michaelbudisch/Keller-Sensorzentrale/enclosure/README.md

# 3D-Gehäuse / MakerWorld

**[→ Gehäuse und Druckprofil auf MakerWorld ansehen](https://makerworld.com/en/models/3464324-wemos-d1-gehause-fur-ds18b20-und-relais#profileId-3953596)**

Für die Keller Sensorzentrale existiert bereits ein vom Projektinhaber entworfenes Gehäuse. **Die 3MF-/STL-Dateien wurden noch nicht zur Repository-Erstellung bereitgestellt.** Fotos und CAD-Ansichten des fertigen Prototyps sind jetzt in der [Projektgalerie](../docs/galerie/README.md) vorhanden. Wir fügen hier bewusst keine erfundenen Modelle, Maße oder Druckprofile hinzu.

## Hier später ablegen

```text
enclosure/
├── README.md
├── MAKERWORLD-TEXT.md
├── models/       ← 3MF, STL, STEP (wenn vorhanden)
├── photos/       ← Gehäusefotos / Explosionsansicht
└── profiles/     ← Slicer-Profil, optional
```

Zur fertigen Dokumentation werden benötigt: finaler 3MF/STL-Stand, Innenmaße / Platinenaufnahme, Verschraubung, Kabelführungen, USB-Zugang, Material- und Druckeinstellungen, Fotos und gewünschte Nutzungs-/Remix-Lizenz.

## Verknüpfung

**[MakerWorld: Wemos D1 Gehäuse für DS18B20 und Relais](https://makerworld.com/en/models/3464324-wemos-d1-gehause-fur-ds18b20-und-relais#profileId-3953596)**

Die 3D-Druck-Dateien werden über die MakerWorld-Modellseite angeboten. Die zugehörige Firmware und die Home-Assistant-Integration befinden sich in diesem GitHub-Repository. Die jeweiligen Lizenzbedingungen sind separat zu prüfen.

Das Gehäuse allein stellt keine elektrische Sicherheit, Flammschutz-Zulassung oder Eignung für Heizöltanks bzw. Ex-Zonen sicher.

## Fertige Beschreibungstexte

[MakerWorld-Beschreibung auf Deutsch und Englisch](MAKERWORLD-TEXT.md). Das Modell ist inzwischen auf MakerWorld veröffentlicht. **Die Bilder sind keine Maßzeichnungen.**
