michaelbudisch/Keller-Sensorzentrale/docs/galerie/README.md

# Projektgalerie – Keller Sensorzentrale

Fotos des aufgebauten Prototyps und Screenshots der beiden Oberflächen. Die Bilder zeigen **eine individuelle Lochrasterplatine**: Maße und Steckerlagen können bei Nachbauten abweichen.

## Gehäuse und Elektronik

Offenes Gehäuse mit Wemos D1 mini, Sensorplatine und Relais
*Innenaufbau des Prototyps mit abgenommener Abdeckung.*

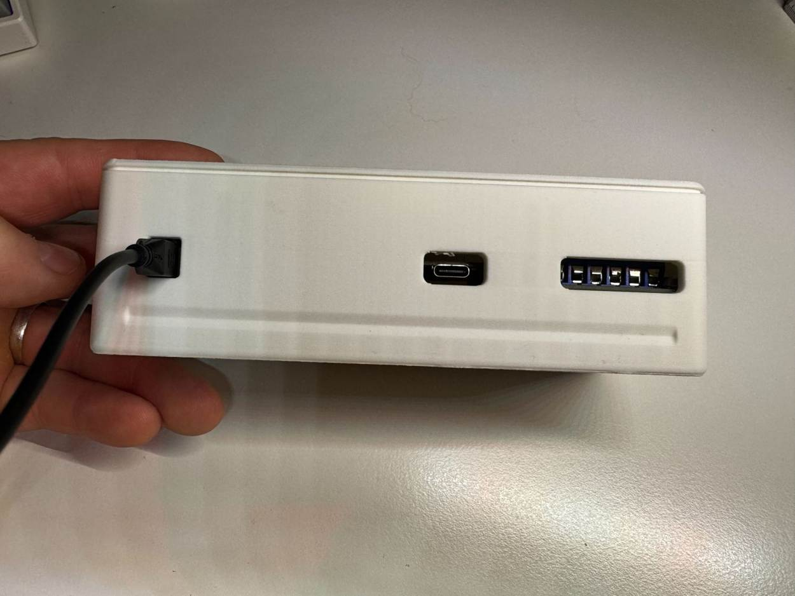
[picture p4: docs/galerie/02-anschluesse.jpg]
Gehäuseanschlüsse an der Längsseite

*Zugängliche Anschlussseite des 3D-gedruckten Gehäuses.*

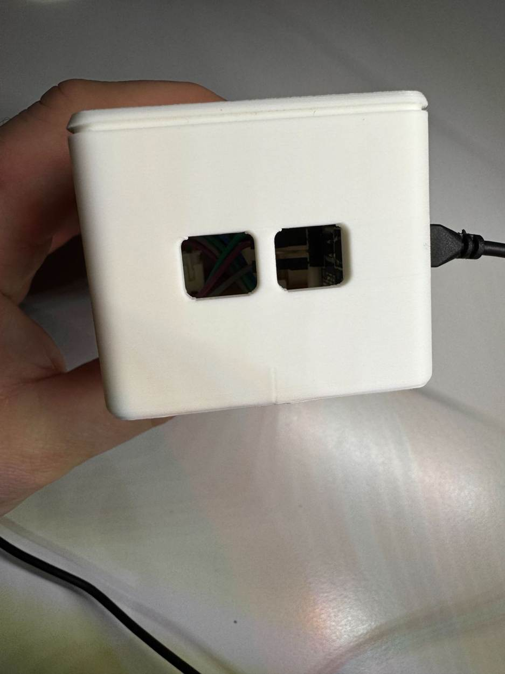
[picture p5: docs/galerie/03-gehaeuse-seite.jpg]
Gehäuse-Seite

*Seitliche Kabelöffnungen.*

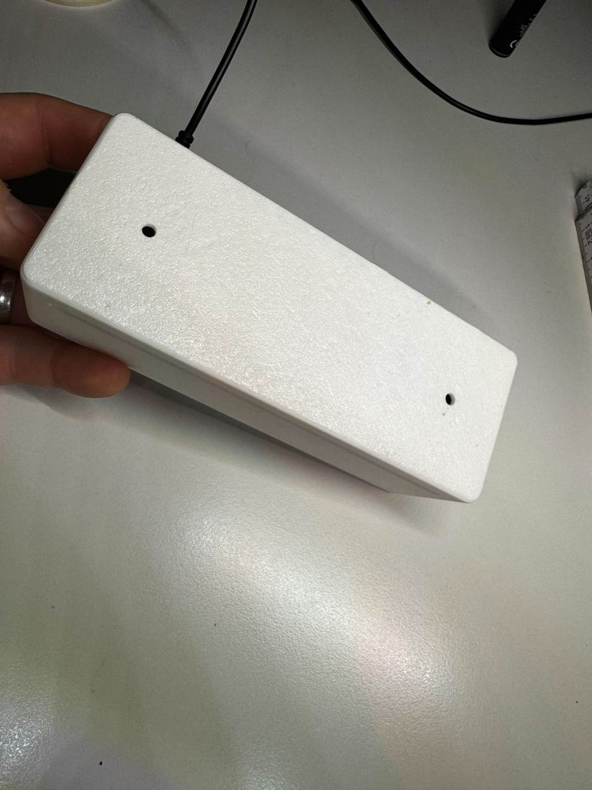
[picture p6: docs/galerie/04-deckel.jpg]
Deckel

*Geschlossener Deckel mit Befestigungspunkten.*

## Montage und CAD

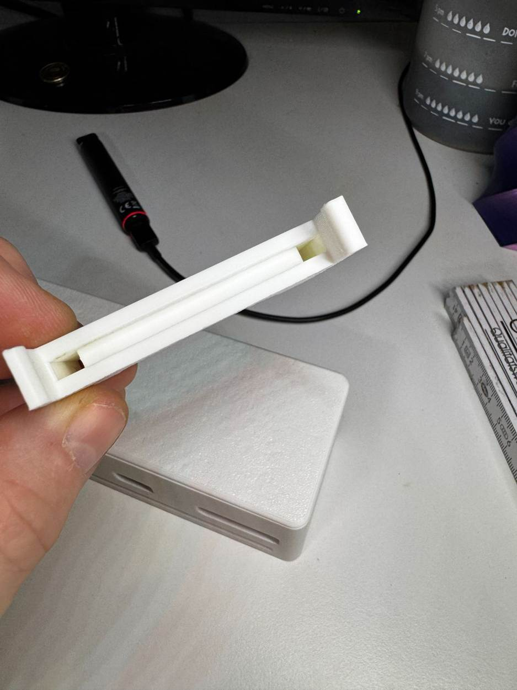
[picture p7: docs/galerie/05-rohrhalter.jpg]
Gedruckte Rohrhalterung

*Einfacher gedruckter Halter des Prototyps.*

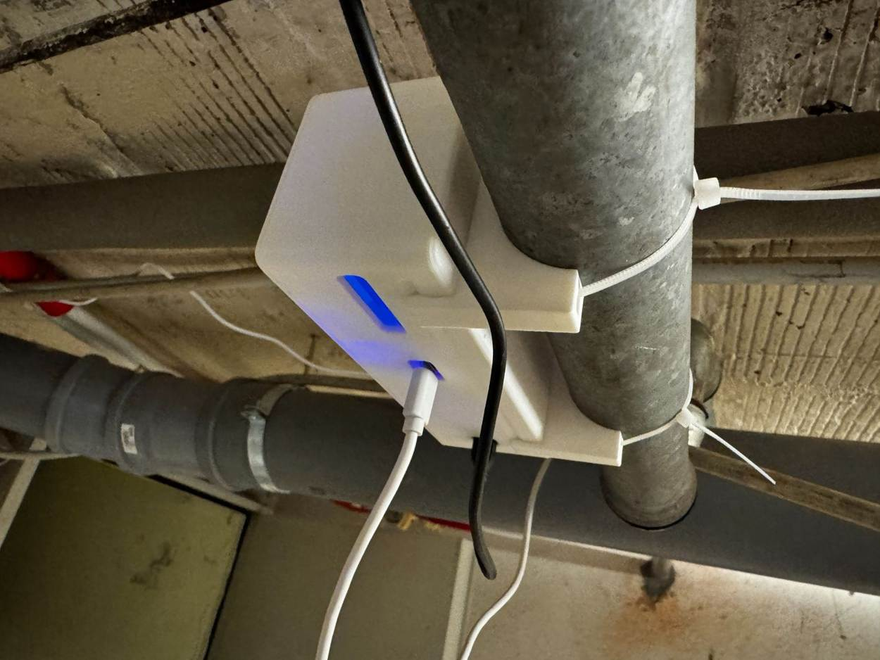
[picture p8: docs/galerie/06-rohrmontage.jpg]
Gehäuse am Rohr montiert

*Individuelle Rohrmontage, hier mit Kabelbindern.*

Montiertes Gerät mit Statusbeleuchtung
*Fertig montierter Aufbau im Keller.*

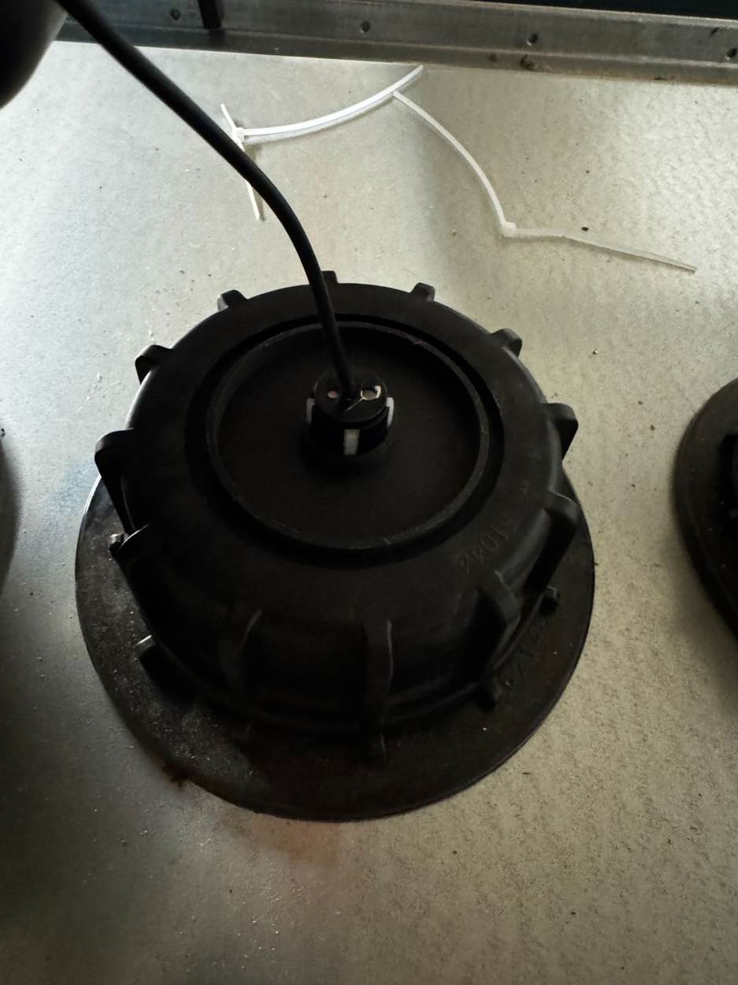
[picture p9: docs/galerie/08-tanksensor.jpg]
Tanksensor am Deckel des Prototyptanks

*Der vorhandene Tankaufbau: **kein** universeller Montageplan und keine Aussage über Tankabdichtung oder Zulassung.*

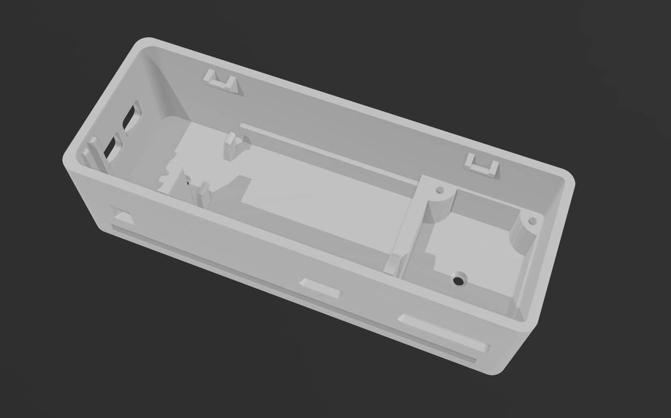
[picture p10: docs/galerie/09-cad-innenansicht.jpg]
CAD-Innenansicht

*CAD-Ansicht mit Haltestrukturen. [3D-Druck-Modell auf MakerWorld](https://makerworld.com/en/models/3464324-wemos-d1-gehause-fur-ds18b20-und-relais#profileId-3953596).*

## Software

Home Assistant Kellersteuerung
*Home Assistant: Relais, Sensor-Slots, Tankfüllstand und Langzeitverläufe.*

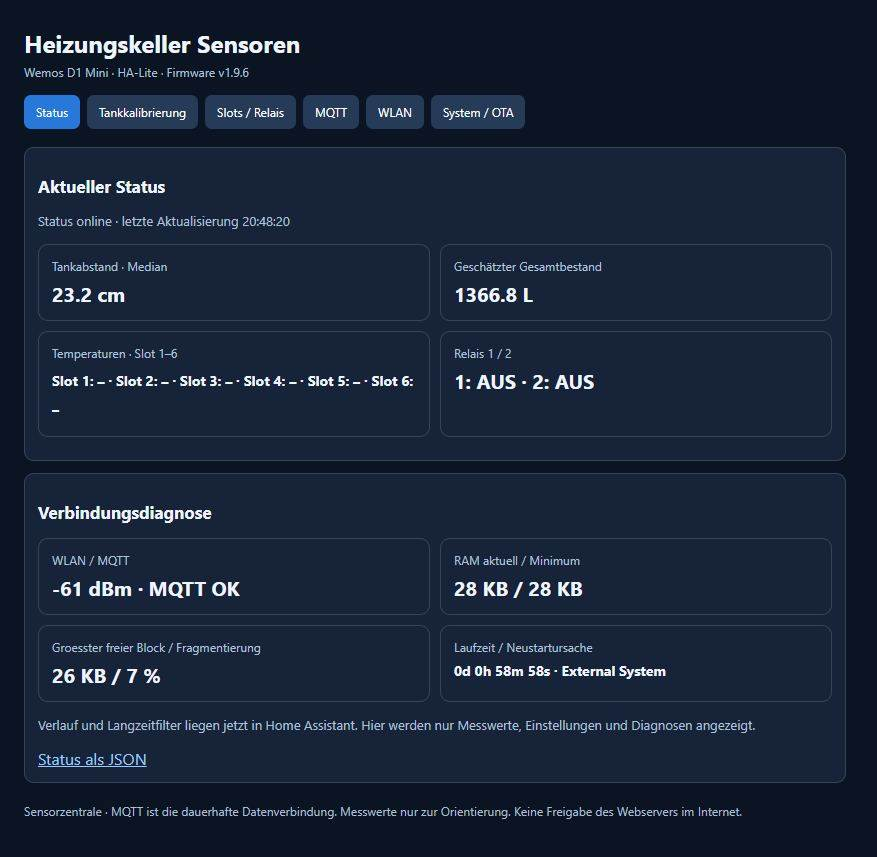
[picture p11: docs/galerie/11-wemos-status.jpg]
Wemos-Status

*Lokale kompakte Status- und Konfigurationsoberfläche des Wemos.*

## Nutzungsrechte und Privatsphäre

Die öffentlich bereitgestellten Fotos sind zur Veranschaulichung des Projekts gedacht. Die MIT-Lizenz des Quellcodes ist **keine pauschale Fotolizenz**. Bitte frage vor einer Weiterverwendung oder dem Nachdruck der Bilder nach. Beim Export wurden Bildmetadaten entfernt.

Das gezeigte Gehäuse ist ein 3D-Druck-Prototyp und nicht als zertifizierte Schutzeinrichtung oder für netzspannungsführende beziehungsweise explosionsgefährdete Installationen geprüft.
