michaelbudisch/Keller-Sensorzentrale/PROJECT_STATUS.md

# Projektstatus – Keller Sensorzentrale

**Stand:** 20.10.2026 · **GitHub-Dokumentationsstand:** v0.2.2 · **Status:** im eigenen Aufbau erprobter Prototyp, kein zertifiziertes Fertigprodukt.

> **Startpunkt für neue Chats und Beiträge:** Vor Änderungen diese Datei und die jeweils aktuellen GitHub-Quelldateien lesen. Der Code im Branch `main` ist die öffentliche Quellbasis; die genaue Konfiguration des bereits installierten Geräts kann davon abweichen. Für Live-Einstellungen und Probleme stets aktuelle Screenshots, Diagnosedaten oder Konfigurationsauszüge heranziehen. Keine Passwörter oder privaten Zugangsdaten ins Repository übernehmen.

## Neuestes Frontend: natives Lovelace-Dashboard

Seit dem 22.10.2026 steht **`home-assistant/Kellersteuerung_Lovelace.yaml`** als neue Standardoberfläche zur Verfügung. Sie wurde statisch validiert, ist aber **noch nicht live im HA des Nutzers getestet**. Sie ersetzt bei erfolgreichem Einsatz das bisherige **eigene** Seitenpanel im Alltag, ohne dessen Installation oder Dateien zu löschen. Einbindung und fehlende Entitätsnamen stehen in [LOVELACE_DASHBOARD.md](docs/home-assistant/LOVELACE_DASHBOARD.md).

## 1. Projektüberblick

Ein Wemos D1 mini (ESP8266) liest einen Ultraschall-Tanksensor und bis zu sechs DS18B20-Temperatursensoren aus, steuert zwei Relais und veröffentlicht die Werte über MQTT an Home Assistant. Im Wemos bleiben Messung, kurzer Median, 16-Punkte-Tankkennlinie, Sensorzuordnung, Relais, Einstellungen und Diagnose. Home Assistant übernimmt zeitliche Glättung, Verlauf, Anzeige und die optional aktivierbare Heizöl-Verbrauchs-/Nachtank-Auswertung.

| Bereich | Öffentlicher Stand | Praxiserfahrung / Grenzen |
| --- | --- | --- |
| ESP8266-Firmware | **v1.9.6 (HA-Lite / Statusfix)** | Eingebauter Wemos übermittelt Tankwerte und MQTT-Status; GitHub-Sketch ist eine von Zugangsdaten bereinigte Vorlage, kein binär identisches Abbild des laufenden Geräts. |
| Home Assistant | **HA-Pakete v2.1.0, Seitenpanel v2.4.0, Lovelace-Karte v2.1.1** | Tankabstand, geglättete Liter und Gesamtbestand erschienen in HA; Schalten der Relais über MQTT/HA wurde beobachtet. |
| Tankmessung | **Aktiv, ein Sensor** | Bei der letzten Rückmeldung funktionierten Distanzmessung und Literanzeige. Beide mechanischen Tankuhren zeigten ungefähr den gleichen Stand; exakte Messtoleranz nicht bestimmt. |
| Tankhochrechnung | **Zwei gleichartige Tanks** | Gemessen wird ein Tank; der zweite wird aus gleichem angenommenem Füllstand hochgerechnet. Im HA-Package ist die aktuelle Einzelkapazität **720 L** für den Prozentwert fest hinterlegt; bei anderen Tanks anpassen. |
| Temperaturslots | **Sechs Buchsen/Slots vorgesehen** | **Zwei angeschlossene DS18B20 an D1 erkannt.** Slot 1 ist als Heizungsvorlauf und Slot 2 als Rücklauf montiert; Screenshot: 37,3 °C und 33,6 °C (3,7 K Spreizung). D2/D5 und Recorder-Verlauf noch nicht getestet. |
| Relais | **Zwei Kanäle** | Status/Steuerung aus HA möglich, lokale Belastbarkeit, Versorgung und dauerhafter Betrieb noch nicht abschließend qualifiziert. Keine Netzspannung/Sicherheitsfunktionen. |
| Verbrauchsstatistik | **Optionales HA-Package vorhanden** | Helfer `input_boolean.keller_verbrauch_aktiv` existiert. Die tatsächliche spätere Aktivierung und belastbare Tages-/Wochen-/Monats-/Jahreswerte sind **nicht abschließend bestätigt**. |
| 3D-Gehäuse | **Veröffentlicht** | [MakerWorld-Modell + Druckprofil](https://makerworld.com/en/models/3464324-wemos-d1-gehause-fur-ds18b20-und-relais#profileId-3953596), [Fotos und Montage](docs/galerie/README.md). Die 3MF/STL-Dateien liegen auf MakerWorld, nicht im GitHub-Repository. |

**Zuletzt gezeigte Beispielwerte (19.10.2026, keine Live-Werte):** Wemos ca. **23,2 cm** Tankabstand und **1.366,8 L** hochgerechneter Bestand. Home Assistant wegen 5-Minuten-Glättung zeitlich versetzt ca. **1.353,8 L / 94,0 %**; früher auch ca. 1.358,8 L / 94,4 %. Solche Momentaufnahmen dürfen nicht als statische Konfigurationswerte oder gesicherte Füllmengen übernommen werden.

## 2. Hardware und GPIO-Belegung

| Anschluss | Wemos D1 mini | Verwendung |
| --- | --- | --- |
| Slot 1 + 2 | **D1 / GPIO5** | 1-Wire-Datenbus A, ein Pull-up (ca. 5 kΩ) an 3,3 V |
| Slot 3 + 4 | **D2 / GPIO4** | 1-Wire-Datenbus B, ein Pull-up (ca. 5 kΩ) an 3,3 V |
| Slot 5 + 6 | **D5 / GPIO14** | 1-Wire-Datenbus C, ein Pull-up (ca. 5 kΩ) an 3,3 V |
| Tank ECHO/TX | **D6 / GPIO12** | Abstandspulse, **mit** geeigneter 5-V-auf-3,3-V-Pegelanpassung |
| Relais 1 | **D7 / GPIO13** | Schaltausgang, im Sketch active LOW voreingestellt |
| Relais 2 | **D0 / GPIO16** | Schaltausgang, im Sketch active LOW voreingestellt |

- **Sechs 3-Pin-Stecker:** jeweils **3V3, DATA, GND**; zwei pro 1-Wire-Bus. Physische Pinreihenfolge keinesfalls aus Fotos ableiten.
- **Zwei 4-Pin-Stecker:** Tank (5V/GND/TX-ECHO/RX-TRIG; RX derzeit frei) und Relais (5V/GND/IN1/IN2). Beide Anschlüsse elektrisch unterscheiden und prüfen.
- **Achtung Pegel:** Der verwendete Prototyp wurde mit drei 5-kΩ-Widerständen als Spannungsteiler aufgebaut (5 kΩ oben / 10 kΩ unten); das liefert nominell **3,33 V** und wenig Reserve. Die [öffentliche Nachbauanleitung](docs/hardware/ANSCHLUSSPLAN.md) beschreibt eine konservativere Pegelanpassung. Kein 5-V-Signal direkt an den GPIO!
- Hardwareanleitungen: [Bauanleitung](docs/hardware/BAUANLEITUNG.md) · [Netzliste](docs/hardware/ANSCHLUSSPLAN.md) · [SVG-Prinzipbild](docs/hardware/anschlussplan.svg) · [Stückliste](docs/hardware/STUECKLISTE.md).

## 3. Software, Datenfluss und Kompatibilität

**Wemos:**
- [`firmware/KellerSensorzentrale/KellerSensorzentrale.ino`](firmware/KellerSensorzentrale/KellerSensorzentrale.ino) – öffentliches v1.9.6-Quelltemplate, drei `#BITTE_AENDERN`-Platzhalter, ESP8266-Boardpaket, WiFiManager, PubSubClient, OneWire und DallasTemperature.
- EEPROM speichert Kalibrierung/Zuordnungen und Geräteeinstellungen. Vor Änderungen oder OTA die lokale Konfiguration sichern.
- Die abgespeckte Weboberfläche dient der Konfiguration und Diagnose; MQTT ist der primäre Home-Assistant-Datenweg.

**Home Assistant:**
- [Installationsanleitung](docs/home-assistant/INSTALLATION.md) und [Dateien](home-assistant/).
- Bestehende Namen aus Kompatibilitätsgründen beibehalten: `www/heizoel-monitor-card.js`, `custom_components/heizoel_dashboard_panel`, Panel-Pfad `/heizoel-monitor`; sichtbarer Titel **Kellersteuerung**.
- Seitenpanel-Update v2.3.1: Heizkreis mit Taktanalyse im eigenen Reiter, Ölbereiche getrennt, ein optionales Package (v1.0.1) liefert abgeleitete Aktivphasen und Statistiken. Im realen HA installiert; erste Tests funktionieren, die Aussagekraft muss über mehrere Tage geprüft werden. [Ausführliche Anleitung](docs/home-assistant/HEIZTAKTE.md).
- Seitenpanel-Update v2.2.0: Vorlauf und Rücklauf standardmäßig aus Slot 1/2, optionaler Spreizungs-Helfer und getrennte Achsen im Verlauf; [Installationsanleitung](docs/home-assistant/INSTALLATION.md#heizkreis-anzeige-im-seitenpanel-v220).
- Lovelace-Kartenupdate v2.1.1: Eine alte `entity:`-Angabe in Karten-YAML darf `entities.total` nicht überschreiben. Bei alter Karte JS-Datei ersetzen, Ressource `/local/heizoel-monitor-card.js?v=211` nutzen und YAML prüfen; siehe [Installation](docs/home-assistant/INSTALLATION.md#lovelace-karte-alte-anzeige-oder-falscher-gesamtbestand).
- HA-Packages liegen im Ordner **`packages/` unmittelbar neben der aktiven `configuration.yaml`**. Bei der realen Installation führte ein irrtümliches zusätzliches `config/`-Unterverzeichnis dazu, dass Helfer zunächst fehlten.
- Bestätigte MQTT-Rohentität: **`sensor.heizungskeller_sensoren_abstand_geglattet`**, ausdrücklich **`geglattet`**, nicht `geglaettet`. Dies war zuvor ein echter Zuordnungsfehler.
- HA-Filter/Template-Entitäten: `sensor.keller_tank_abstand_5min`, `sensor.keller_tank_einzeln_5min`, `sensor.keller_tank_gesamt_5min`, `sensor.keller_tank_fuellstand_5min`.
- Verbraucher-Helfer: `input_boolean.keller_verbrauch_aktiv`. Der Verbrauchsalgorithmus enthält Schwellenwerte und benötigt die Prüfung anhand realer Tage, längerer Ausfälle und Nachtank-Vorgänge. Nicht eigenmächtig Null setzen oder Statistiken zurücksetzen.

## 4. Bekannte Grenzen und noch offene Prüfungen

1. **Webserver-Stabilität:** Historisch war die Weboberfläche zeitweise unerreichbar, während MQTT/HA-Relais weiter funktionierten. Nach HA-Lite ca. **27–29 KB freier Heap** in gezeigten Momentaufnahmen, aber **keine belastbare Langzeit-Entwarnung**. Bei neuen Ausfällen Heap-Minimum, größter Block, Fragmentierung, Neustartursache, Laufzeit sowie WLAN/MQTT erfassen.
2. **Langzeittest und Zuverlässigkeit:** Keine systematisch dokumentierten Wiederanlauf-, Sensorabbruch-, WiFi/MQTT-Ausfall- und Relaisschalt-Lasttests.
3. **Temperatur:** D1 mit zwei erkannten DS18B20 bestätigt. D2/D5 und Recorder-Verlauf sowie neue Heizkreis-Grafik im laufenden HA testen. Für 30-Tage-Grafiken Recorder-Aufbewahrung prüfen.
4. **Tankkalibrierung:** Gegen die mechanischen Uhren plausibilisiert, aber Verbrauchsschwellwerte, Toleranzen und Tankgleichlauf über Zeit sowie Füllstand bei verschiedenen Pegeln noch zu prüfen.
5. **Firmware-Build:** Die öffentliche v1.9.6-Vorlage wurde beim Projekt-Export **nicht als vollständiger reproduzierbarer ESP8266-Build bzw. Hardware-Test** verifiziert. Die drei persönlichen Zugangsdaten gehören niemals in Git.
6. **Schaltplan:** Der GitHub-Plan ist eine elektrische Prinzipskizze, kein fertig geprüfter PCB-/Gerber-Entwurf. Steckerausrichtung, Pegel, 3,3-V-Tauglichkeit und Stromversorgung bei einem Nachbau erneut prüfen.
7. **Sicherheit:** Keine Netzspannung oder sicherheitsrelevante Heizungssteuerung über den DIY-Prototyp. Tanksensor und Gehäuse sind nicht als zugelassene Einrichtungen für Tankinnenraum oder explosionsgefährdete Bereiche nachgewiesen. Fachgerechte Montage und Zulassungen eigenständig prüfen.

## 5. Aufgabenliste (nächste sinnvolle Arbeiten)

- [x] Zwei DS18B20 an D1 erkannt; Slot 1 am Vorlauf, Slot 2 am Rücklauf montiert.
- [x] Vorlauf/Rücklauf/Spreizung des Panels v2.2.0 im laufenden Home Assistant mit wiederholten Peaks bestätigt.
- [x] Erster Live-Test mit Heiztakt-Package v1.0.0 und Panel v2.3.0: mindestens ein erkannter Temperaturzyklus.
- [x] Korrektur v1.0.1 und Panel v2.3.1 im Live-Test: Startzählung und einzelne Temperaturstatistiken laufen; eine alte fehlerhafte Pause bleibt noch gespeichert.
- [x] Panel v2.3.2: 24h-Statistiken anhand bestätigter Entitätsnamen korrigiert; Live-Status der einzelnen Werte noch weiter beobachten.
- [ ] Panel v2.4.0 installieren und Tagesgrafik, Datumsauswahl, 6h-Zoom sowie Verfügbarkeit früherer Recorder-Tage in Home Assistant testen.
- [ ] Falschen Pausenausreißer aus der alten Erstberechnung nach Backup bei Bedarf gezielt korrigieren.
- [ ] 24h-Statistiken und Temperaturzyklenerkennung über mehrere Tage prüfen.
- [ ] DS18B20 an D2/D5 ergänzen und Temperaturhistorie prüfen.
- [ ] Webserver- und MQTT-Stabilität mehrere Tage beobachten, Diagnose erfassen und ggf. HTTP/Heap gezielt optimieren.
- [ ] Reproduzierbare Arduino-Buildumgebung mit exakten Bibliotheksversionen und Compile-Test einrichten.
- [ ] Home-Assistant-Verbrauchslogik mit echten Messreihen validieren, Nachtank-Erkennung testen und ggf. dokumentierte Referenzierung ergänzen.
- [ ] Hardware-Bauanleitung gegen finale Platine und Gehäusemaße prüfen; Fotos sind kein eindeutiger Stromlaufplan.
- [ ] Releaselogik/Changelog und Sicherheitsprüfung bei jedem neuen Softwarestand beibehalten.
- [x] Projekt auf GitHub veröffentlicht; MakerWorld-Gehäuse verlinkt.

## 6. Vereinbarter Workflow für weitere Entwicklungs-Chats

1. **GitHub zuerst:** Vor jeder Codearbeit den aktuellen Branch `main`, diese Datei, README, `CHANGELOG.md` und betroffene Quelldateien live einlesen.
2. **Nicht von Alt-Chats übernehmen:** Frühere Chat-ZIPs, Versionen und vermutete GPIO-/Entity-Namen gelten nicht automatisch als gültig. Abweichungen zur laufenden Installation explizit klären.
3. **Änderungen klein und nachvollziehbar:** Firmware vX.Y.Z, HA-Version und Repo-Dokumentationsversion **getrennt** führen; keine künstlichen Firmware-Upgrades bei reinen README-/Foto-Änderungen.
4. **Testen statt versprechen:** Syntax-/YAML-Prüfungen, möglichst ESP8266-Kompilierung, Änderungsvergleich und Auswirkungen auf MQTT Discovery, EEPROM, HA-Entity-IDs, Kalibrierung und Relaisstartzustand prüfen. Nicht durchgeführte Hardwaretests benennen.
5. **Veröffentlichen:** Dokumentation, `CHANGELOG.md`, Versionsübersicht und diese Datei synchron aktualisieren; GitHub-Commit/Link nennen. Zugangsdaten und lokale IP-Adressen niemals veröffentlichen.
6. **Bei lokaler Installation:** Vor dem Firmware-Update aktuelle Einstellungen sichern, vor Home-Assistant-Änderungen die aktiven YAML-Dateien und Zählerstände sichern; keine bestehenden Zähler unbemerkt zurücksetzen.

## 7. Wichtigste Links

- [GitHub-Repository](https://github.com/michaelbudisch/Keller-Sensorzentrale)
- [Softwareinstallation](docs/home-assistant/INSTALLATION.md)
- [Elektrische Bauanleitung](docs/hardware/BAUANLEITUNG.md)
- [Projektbilder](docs/galerie/README.md)
- [MakerWorld-Gehäuse](https://makerworld.com/en/models/3464324-wemos-d1-gehause-fur-ds18b20-und-relais#profileId-3953596)

---

*Diese Datei beschreibt den zuletzt **berichteten** Entwicklungs- und Teststand; sie ist kein automatischer Live-Status des Wemos oder von Home Assistant.*

## Live-Abgleich Ölverbrauch (23.10.2026)

Screenshots der HA-Zustandsliste bestätigen `sensor.heizoel_verbrauch_kalenderwoche` = 0 L und `sensor.heizoel_verbrauch_kalendermonat` = 0 L. Der für das Verbrauchs-Package genutzte `sensor.heizoel_verbrauch_gesamt` steht bei 33,2 L; ein separater Sensor `sensor.heizoel_verbrauch_kumuliert` steht dagegen auf 0 L und wird **nicht** als Ersatz eingetragen. Das Lovelace-Dashboard v1.0.2 verwendet genau die bestätigten Entitäten. Keine Änderung der Verbrauchs-Engine oder gespeicherter Zählerstände.
