michaelbudisch/Keller-Sensorzentrale/VERSIONEN.md

# Versionen und Entwicklungsstand

- **GitHub-Dokumentation:** v0.2.2 – [aktueller Projektstatus](PROJECT_STATUS.md).

- **Firmware:** v1.9.6 Statusfix / HA-Lite (ESP8266-Arduino), publizierte Datei nach Entfernung der Zugangsdaten und Umbenennung in `KellerSensorzentrale.ino`.
- **Home Assistant – neue Anzeige:** natives Lovelace-Dashboard v1.0.2 mit sieben Ansichten, ohne HACS; alte Ansicht zur Kompatibilität weiter im Repo.\n- **Home Assistant:** HA-Tank-Pakete v2.1.0, Heiztakt-Package v1.0.1 (optional), Seitenpanel v2.4.0 und Lovelace-Karte v2.1.1; der bestätigte Abstand-Entity-Name wurde korrigiert.
- **Tankkennlinie:** Wird im Wemos gespeichert, nicht als verbindliche Herstellerkennlinie vorgegeben.
- **Hardware:** Prototyp mit 6×3-Pin und 2×4-Pin, kein PCB-Gerber-Layout verfügbar.
- **Gehäuse:** [3D-Druck-Modell auf MakerWorld](https://makerworld.com/en/models/3464324-wemos-d1-gehause-fur-ds18b20-und-relais#profileId-3953596) veröffentlicht; 3MF/STL werden separat dort bereitgestellt und nicht im GitHub-Repository dupliziert.

Die MIT-Lizenz ist für den GitHub-Export vorbereitet. Vor einer produktiven Übernahme den sanitisierten Sketch lokal kompilieren, Foto-/Modellrechte prüfen und den README-Hinweisen folgen.
