michaelbudisch/Keller-Sensorzentrale/LIZENZ-ENTSCHEIDUNG.md

# Lizenz und Rechte vor der GitHub-Veröffentlichung

Das öffentliche **Quellcode- und Dokumentationspaket** ist unter der [MIT-Lizenz](LICENSE) vorbereitet. Diese erlaubt kostenlose private und kommerzielle Nutzung, Änderungen und Weiterverbreitung bei Beibehaltung des Copyright- und Lizenzhinweises.

Die Rechtezeile `Keller Sensorzentrale contributors` ist ein vorläufiger Sammelname. Der Projektinhaber kann vor der Erstveröffentlichung den eigenen GitHub-Namen bzw. Urheberangaben ergänzen. Prüfe, ob du sämtliche beigefügten Fotos und sonstigen Materialien unter dieser Lizenz veröffentlichen darfst.

**Das 3D-Gehäuse ist noch nicht Bestandteil dieses Pakets.** Wenn STL-/3MF-Dateien später auf MakerWorld veröffentlicht werden, kann für diese Modelle eine separate, ausdrücklich zu nennende Lizenz gelten.

Eingesetzte Arduino- und Home-Assistant-Abhängigkeiten verbleiben unter ihren eigenen Lizenzen. Es wurden keine Fremdbibliotheken in dieses Repository kopiert. Vor dem tatsächlichen öffentlichen Push alle Lizenz- und Rechtefragen gegenprüfen.
