michaelbudisch/Keller-Sensorzentrale/(commit log)

2026-10-19 docs: initialize public Keller Sensorzentrale repository
2026-10-19 feat: publish Keller Sensorzentrale firmware, HA and hardware documentation
2026-10-19 docs: add enclosure gallery, installation photos and MakerWorld descriptions
2026-10-19 docs: link published MakerWorld enclosure model (v0.1.3)
2026-10-20 feat(panel): add heating supply, return and differential trends (v2.2.0)
2026-10-20 feat: separate heating cycles dashboard and HA thermal cycle analytics (v0.1.7)
2026-10-20 fix(heat cycles): ignore uninitialized first pause and resolve HA statistics entities (v0.1.8)
    [keller_heiztakte.yaml]
2026-10-20 fix(panel): resolve confirmed HA statistics IDs and group heating metrics (v2.3.2)
2026-10-21 feat(panel): daily heating chart with expandable calendar and six-hour detail views (v2.4.0)
